solde/PEC/doc/osciloscopeLight.jpeg

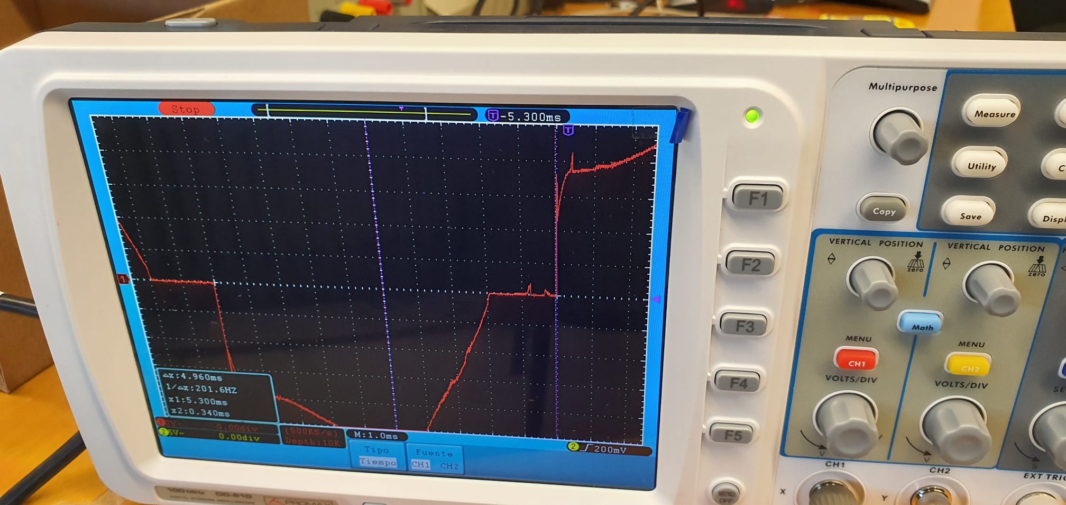
doc/osciloscopeLight.jpeg
