solde/PEC/doc/osciloscopeAc.jpeg

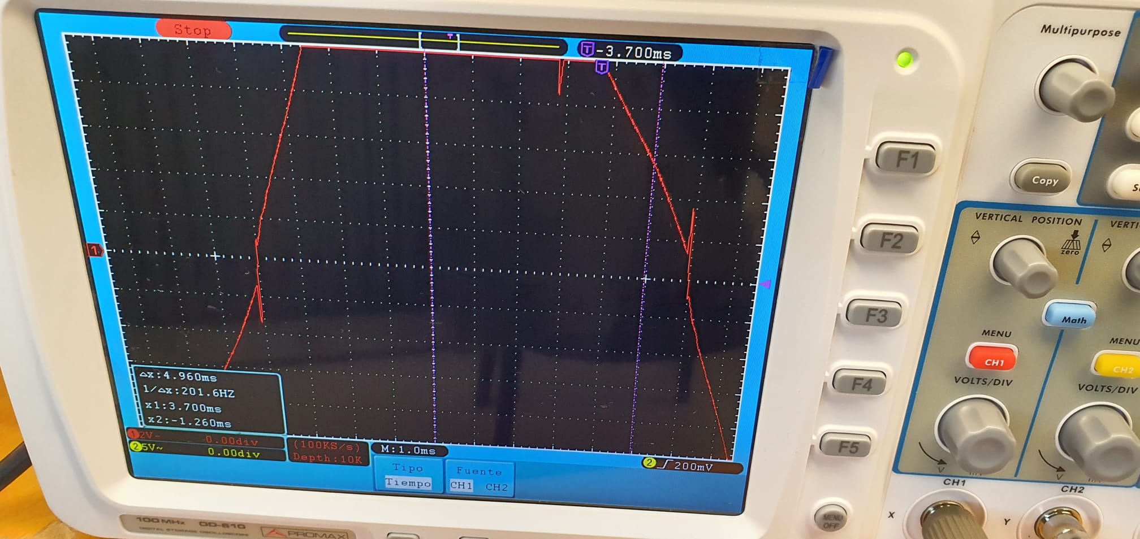
doc/osciloscopeAc.jpeg
