solde/PEC/doc/BOM.xlsx

Sheet: Comanda_Material
Provider | Description + Link | Code | Units | Prize | Total Prize
Leantec | MQ9 Gas sensor -> https://leantec.es/tienda/mq135-mq-135-sensor-air-quality-sensor-hazardous-gas-detection-module-arduino/ | 264389596457 | 1 | 2.90 € | 2.90 €
DigiKey | esp12 -> https://www.digikey.com/catalog/en/partgroup/esp8266-smt-module-esp-12e/59878 | 1528-1438-ND | 1 | 6.95 € | 6.95 €
DigiKey | optoisolator Triac -> https://www.digikey.es/product-detail/en/on-semiconductor/MOC3021M/MOC3021MFS-ND/284883 | MOC3021MFS-ND | 1 | 0.49 € | 0.49 €
Farnell | optoacoplator -> https://es.farnell.com/on-semiconductor/4n25m/optocoupler-transistor-o-p/dp/1021349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 | 1021349 | 1 | 0.45 € | 0.45 €
Farnell | Full Bridge Rectifier -> https://es.farnell.com/multicomp/w02g/diodo-puente-recific-1-fase-200v/dp/2675421?st=w02g | 2675421 | 1 | 0.45 € | 0.45 €
Farnell | Triac -> https://es.farnell.com/on-semiconductor/bd439g/transistor-npn-60v-4a-to-225/dp/2845299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 | 2845299 | 1 | 0.61 € | 0.61 €
Farnell | Led-Red 1206 -> https://es.farnell.com/kingbright/kpt-3216ec/led-1206-red-15mcd-625nm/dp/2099245?st=LED-1206 | 2099245 | 2 | 0.14 € | 0.29 €
Farnell | PIR -> https://es.farnell.com/mcm/287-18001/sensing-range-max-7m/dp/2830979 | 2830979 | 1 | 3.04 € | 3.04 €
DigiKey | Arduino Uno -> https://www.digikey.es/product-detail/en/arduino/A000073/1050-1041-ND/3476357 | A000073 | 1 | 18.59 € | 18.59 €
Farnell | LDR -> https://es.farnell.com/advanced-photonix/nsl-19m51/light-dependent-resistor-550nm/dp/3168335 | 3168335 | 1 | 1.11 € | 1.11 €
Farnell | Connector 2 pin -> https://es.farnell.com/phoenix-contact/1711725/bloque-terminal-pcb-5-08-mm-2/dp/3041165?st=conector%20tornillo | 3041165 | 3 | 1.16 € | 3.48 €
Farnell | Connector 3 pin ->https://es.farnell.com/phoenix-contact/1715734/bloque-terminal-pcb-3-v-as-26/dp/3041530?st=conector%20tornillo | 3041530 | 1 | 1.62 € | 1.62 €
Farnell | Temperature & Humidity DHT11 -> https://es.farnell.com/dfrobot/dfr0067/sensor-de-temperatura-humedad/dp/2946103 | 2946103 | 1 | 4.48 € | 4.48 €
Farnell | Connector 3 pin cable a placa -> https://es.farnell.com/harwin/m22-2010305/conector-macho-tht-2-mm-3-v-as/dp/671927 | 671927 | 3 | 0.13 € | 0.39 €
 |  |  |  | TOTAL = | 44.84 €

Sheet: Pivot_Table_1
(empty)
