solde/PEC/box/arduinoUnoSimplified.STEP

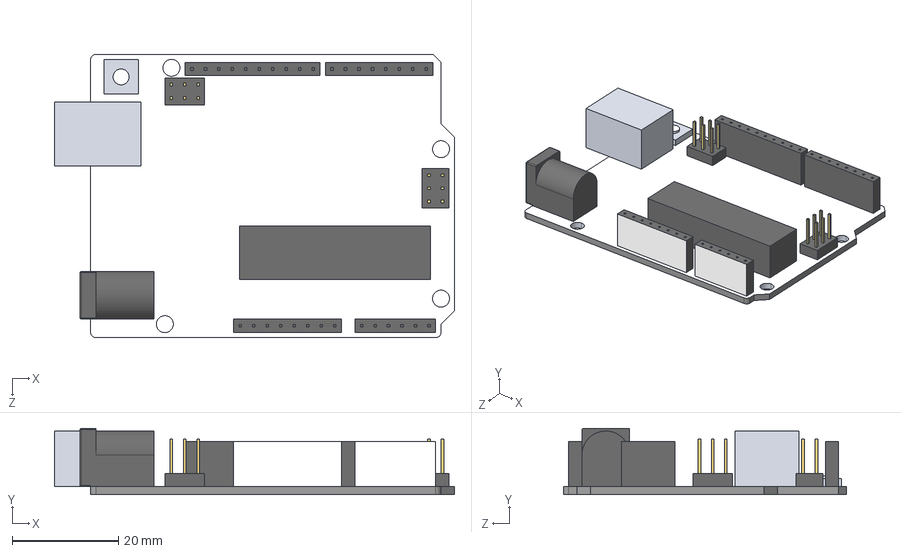
[picture p7: CAD file, 2019-12-27]
box/arduinoUnoSimplified.STEP
75.4 x 12.5 x 53.4 mm
