solde/PEC/box/case_base_arduino.STL

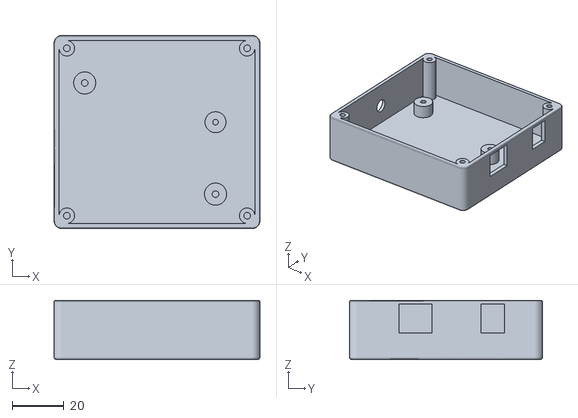
[picture p8: CAD file, 2019-12-27]
box/case_base_arduino.STL
80.0 x 75.0 x 23.0
