solde/PEC/(list of files, cad)

Other CAD files:
box/housing.skp
