solde/PEC/scm/GreenPCB/control AC.brd

## EAGLE design scm/GreenPCB/control AC.brd (2020-01-16)

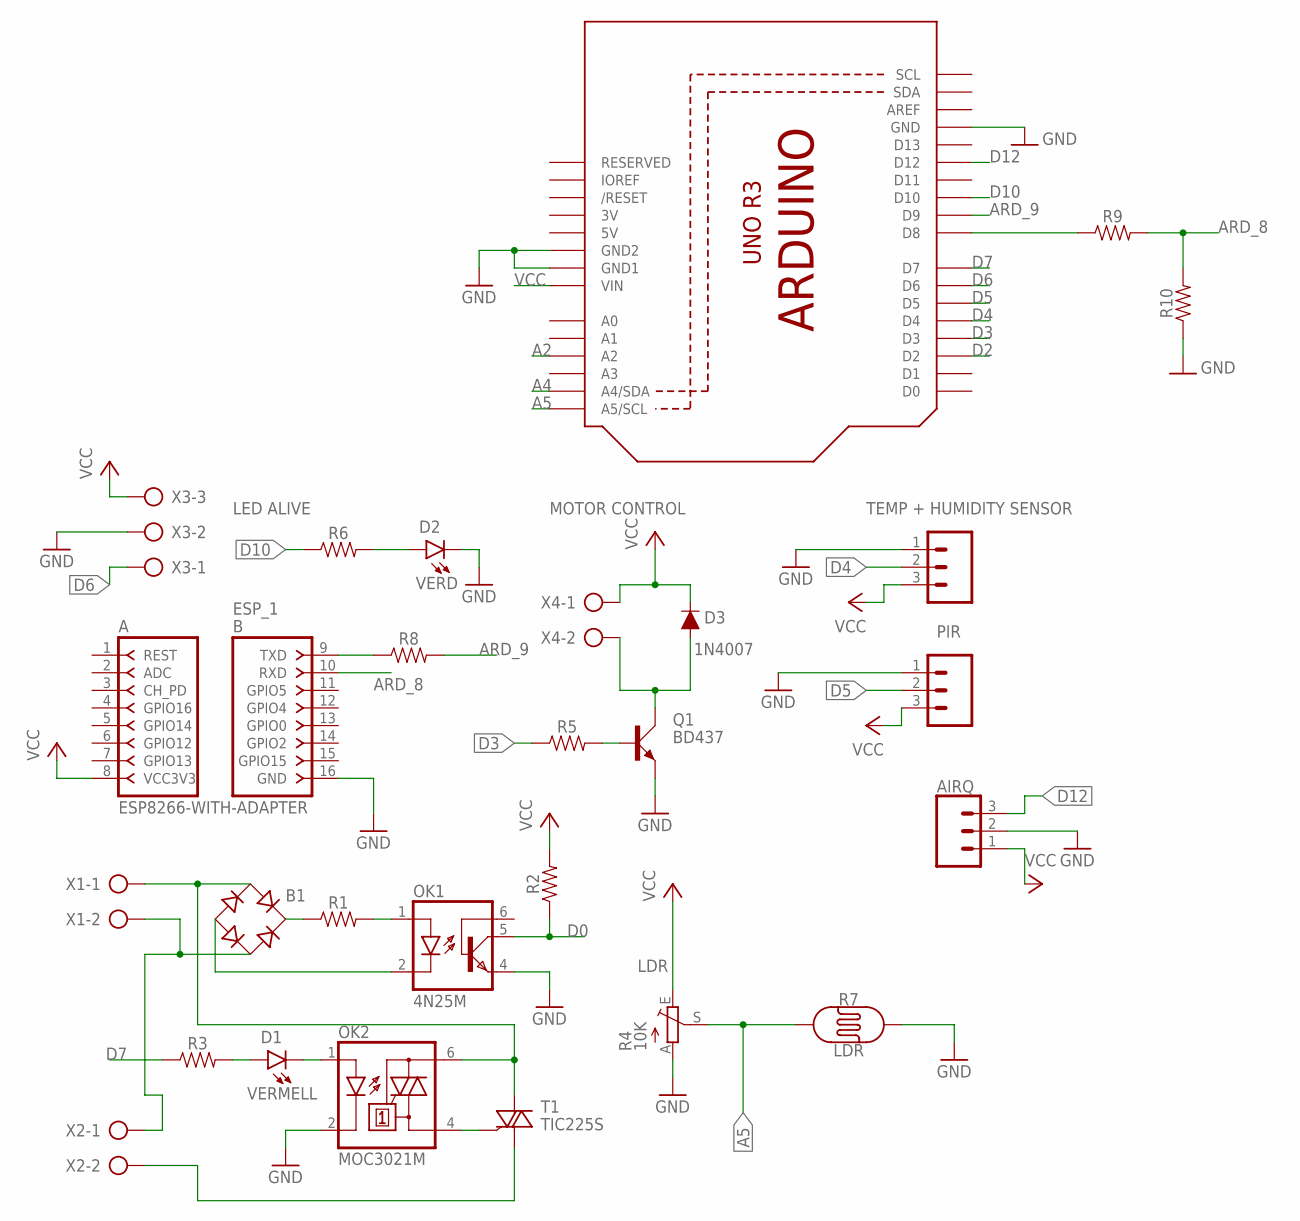
[picture p9: schematic control AC.sch]

Parts:
AIRQ: CONN_03; 1X03
B1: RB1A
D1: VERMELL; LED-1206
D2: VERD; FKIT-LED-1206
D3: 1N4007; DIODE-1N4001
ESP_1: ESP8266-WITH-ADAPTER; ESP8266-ADAPTER
OK1: 4N25M; DIL06
OK2: MOC3021M; DIL06
PIR: 455-1750-1-ND; 1X03
Q1: BD437; TO126AV
R1, R2, R3, R5, R6, R8, R9, R10: 0805
R4: 10K; LI10
R7: LDR; PHOTOCELL-KIT
T1: TIC225S; TO220DS
TEMP+HUM: 455-1750-1-ND; 1X03
U2: ARDUINOR3-DIMENSION; ARDUINOR3
X1, X2, X4: AK500/2
X3: AK500/3

Connections:
3V: U2.3V
5V: U2.5V
A2: U2.A2
A4: U2.A4 (A4/SDA)
A5: R4.S, R7.1, U2.A5 (A5/SCL)
ARD_8: ESP_1.10 (RXD), R9.2, R10.2
ARD_9: R8.2, U2.D9
D0: OK1.5 (COL), R2.1
D2: U2.D2
D3: R5.1, U2.D3
D4: TEMP+HUM.2, U2.D4
D5: PIR.2, U2.D5
D6: U2.D6, X3.1
D7: R3.1, U2.D7
D10: R6.1, U2.D10
D12: AIRQ.3, U2.D12
GND: AIRQ.2, D2.C, ESP_1.16 (GND), OK1.4 (EMI), OK2.2 (C), PIR.1, Q1.E, R4.A, R7.2, R10.1, TEMP+HUM.1, U2.GND, U2.GND1, U2.GND2, X3.2
unnamed: OK1.1 (A), R1.2
unnamed: B1.+, R1.1
unnamed: B1.-, OK1.2 (C)
unnamed: B1.AC1, OK2.6 (A2), T1.A2, X1.1
unnamed: B1.AC2, X1.2, X2.1
unnamed: Q1.B, R5.2
unnamed: D1.A, R3.2
unnamed: D1.C, OK2.1 (A)
unnamed: D2.A, R6.2
unnamed: OK2.4 (A1), T1.G
unnamed: T1.A1, X2.2
unnamed: D3.A, Q1.C, X4.2
unnamed: ESP_1.9 (TXD), R8.1
unnamed: R9.1, U2.D8
VCC: AIRQ.1, D3.C, ESP_1.8 (VCC3V3), PIR.3, R2.2, R4.E, TEMP+HUM.3, U2.VIN, X3.3, X4.1

Notes on the sheet:
LED ALIVE
MOTOR CONTROL
TEMP + HUMIDITY SENSOR
PIR
LDR

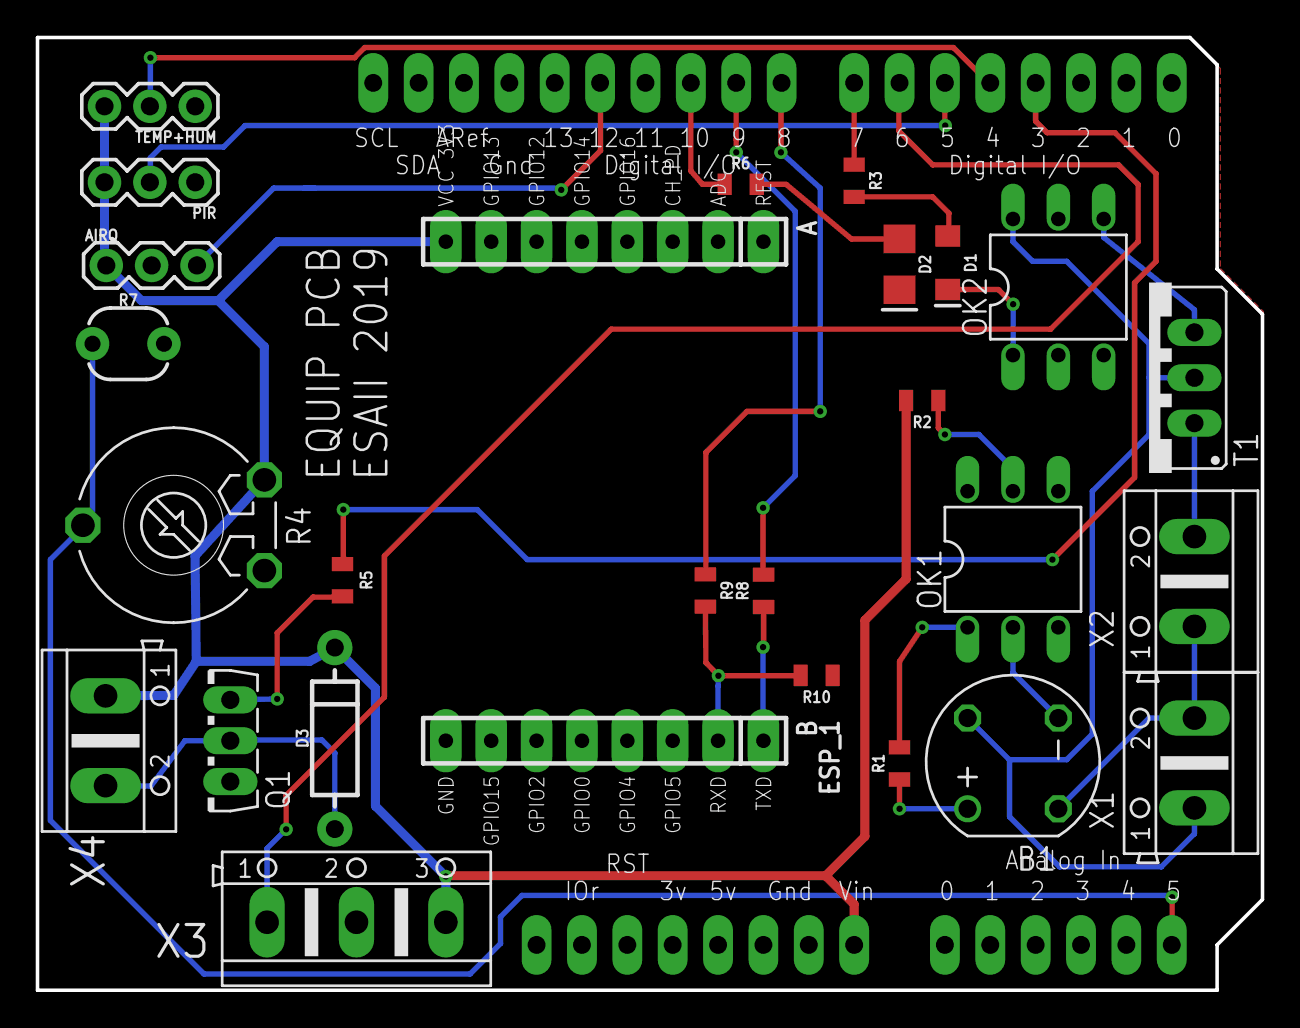
[picture p10: board control AC.brd from above]

Board: 2 copper layers, 68.6 x 53.3 mm, 27 parts (0 on the bottom side), 27 nets.
