solde/PEC/scm/dl3.brd

## EAGLE design scm/dl3.brd (2019-12-27)

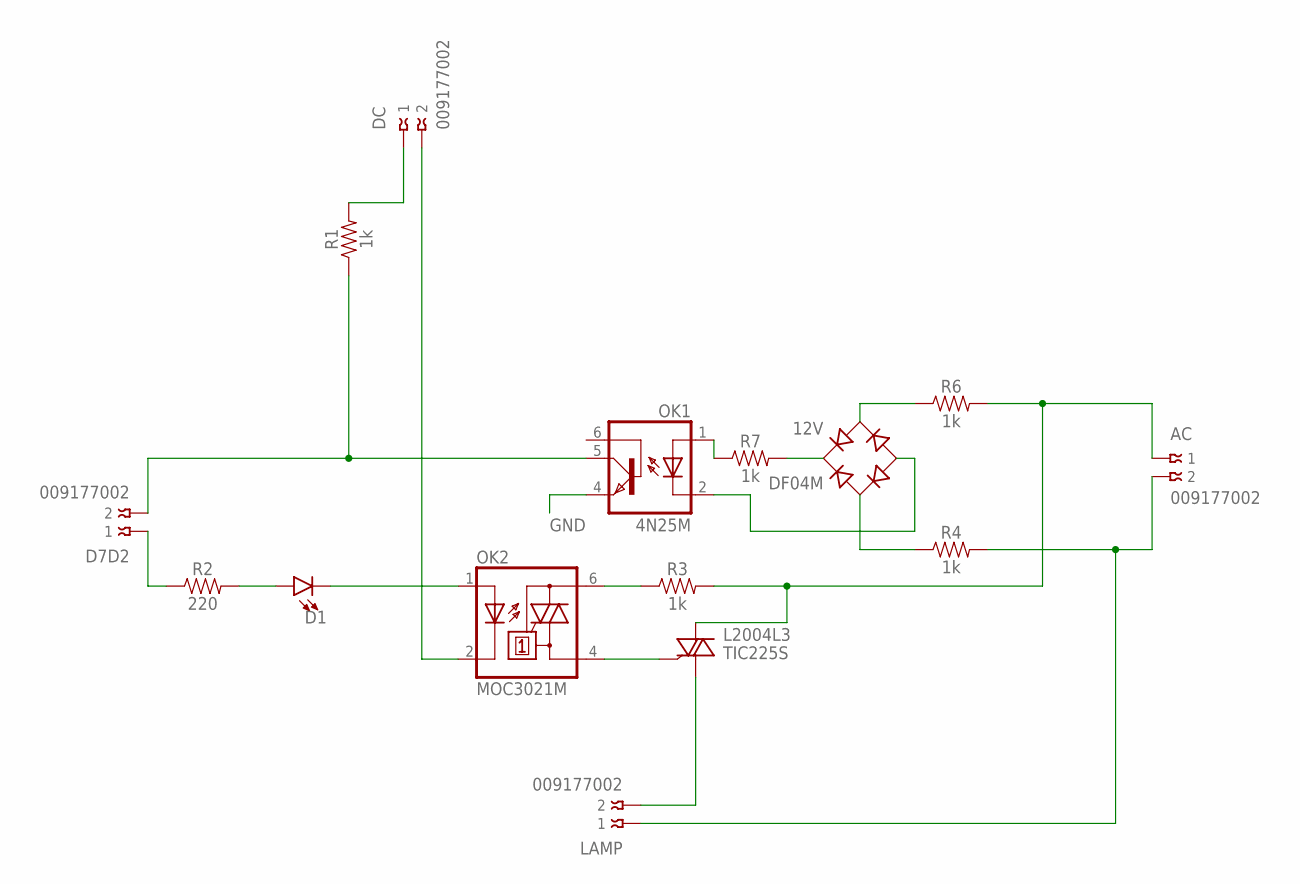
[picture p11: schematic dl3.sch]

Parts:
AC: 009177002
D1: LED1206; LED-1206
D7D2: 009177002
DC: 009177002
DF04M: 12V; B-DIL
L2004L3: TIC225S; TO220DS
LAMP: 009177002
OK1: 4N25M; DIL06
OK2: MOC3021M; DIL06
R1, R3, R4, R6: 1k; AXIAL-0.3
R2: 220; 0805
R7: 1k; 0805

Connections:
GND: AC.2, LAMP.1, OK1.4 (EMI), R4.P$2 (2)
IO2: D7D2.2, OK1.5 (COL), R1.P$1 (1)
unnamed: DF04M.+, R7.2
unnamed: D1.A, R2.2
unnamed: D1.C, OK2.1 (A)
unnamed: D7D2.1, R2.1
unnamed: DC.1, R1.P$2 (2)
unnamed: OK2.6 (A2), R3.P$1 (1)
unnamed: L2004L3.G, OK2.4 (A1)
unnamed: OK1.1 (A), R7.1
unnamed: DF04M.-, OK1.2 (C)
unnamed: DF04M.AC1, R4.P$1 (1)
unnamed: DC.2, OK2.2 (C)
unnamed: AC.1, L2004L3.A2, R3.P$2 (2), R6.P$2 (2)
unnamed: DF04M.AC2, R6.P$1 (1)
unnamed: L2004L3.A1, LAMP.2

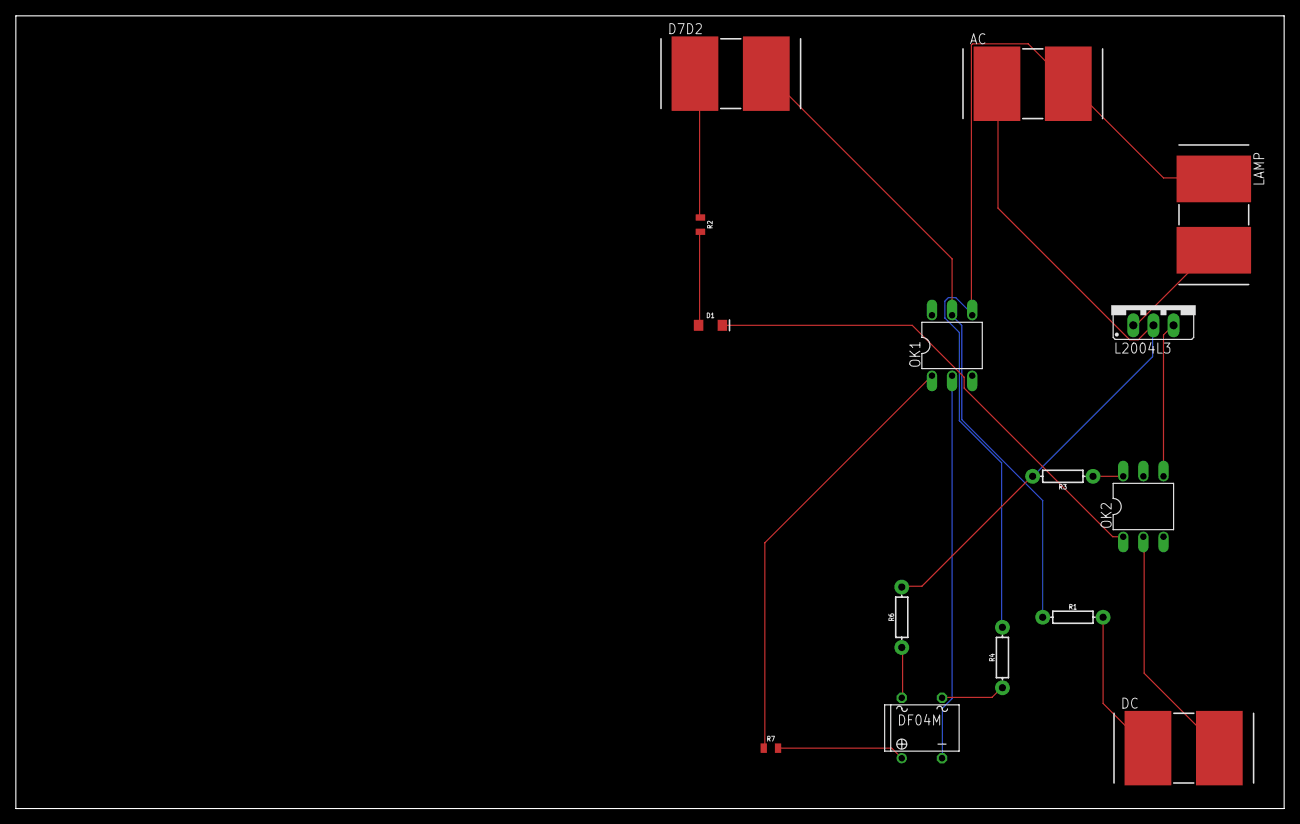
[picture p12: board dl3.brd from above]

Board: 2 copper layers, 160.0 x 100.0 mm, 15 parts (0 on the bottom side), 16 nets.
