solde/PEC/scm/LightDiming.brd

## EAGLE design scm/LightDiming.brd (2019-12-27)

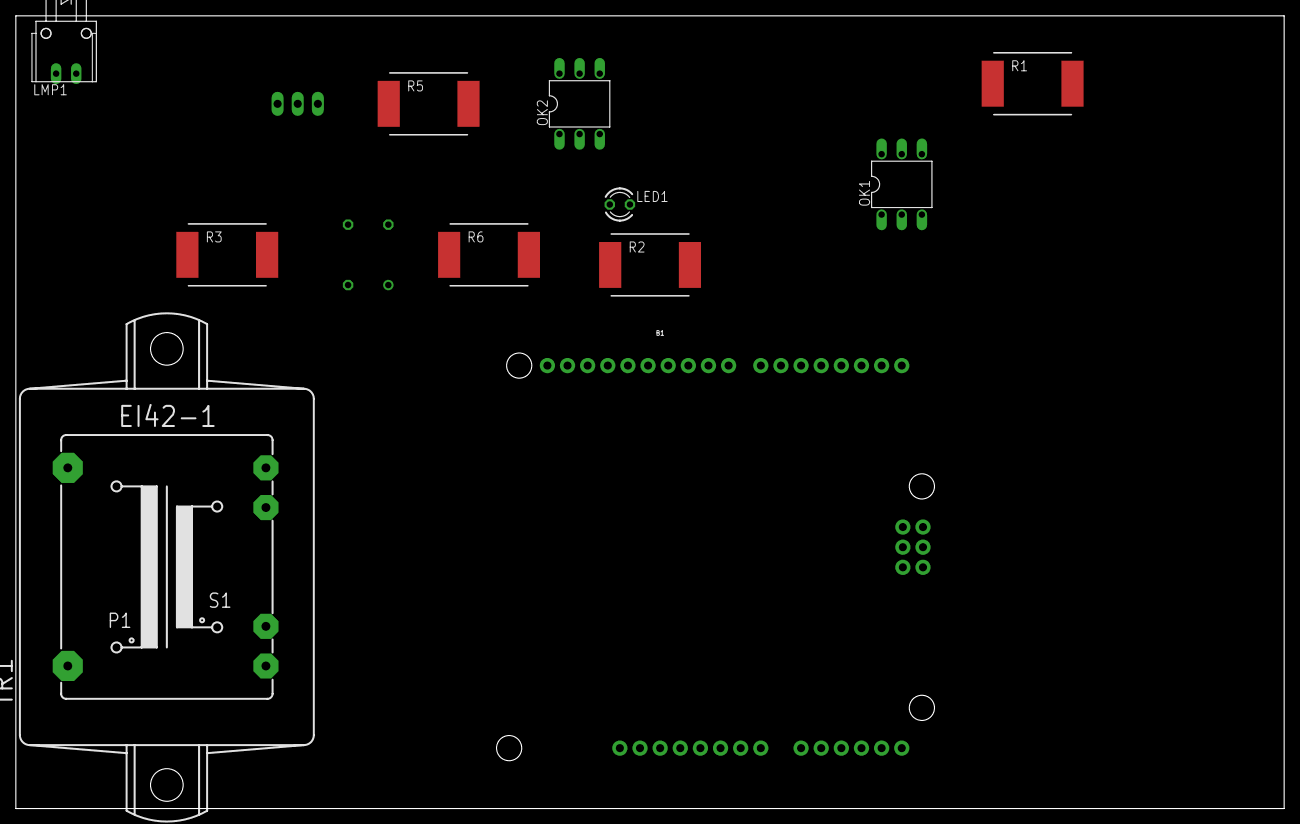
[picture p13: board LightDiming.brd from above]

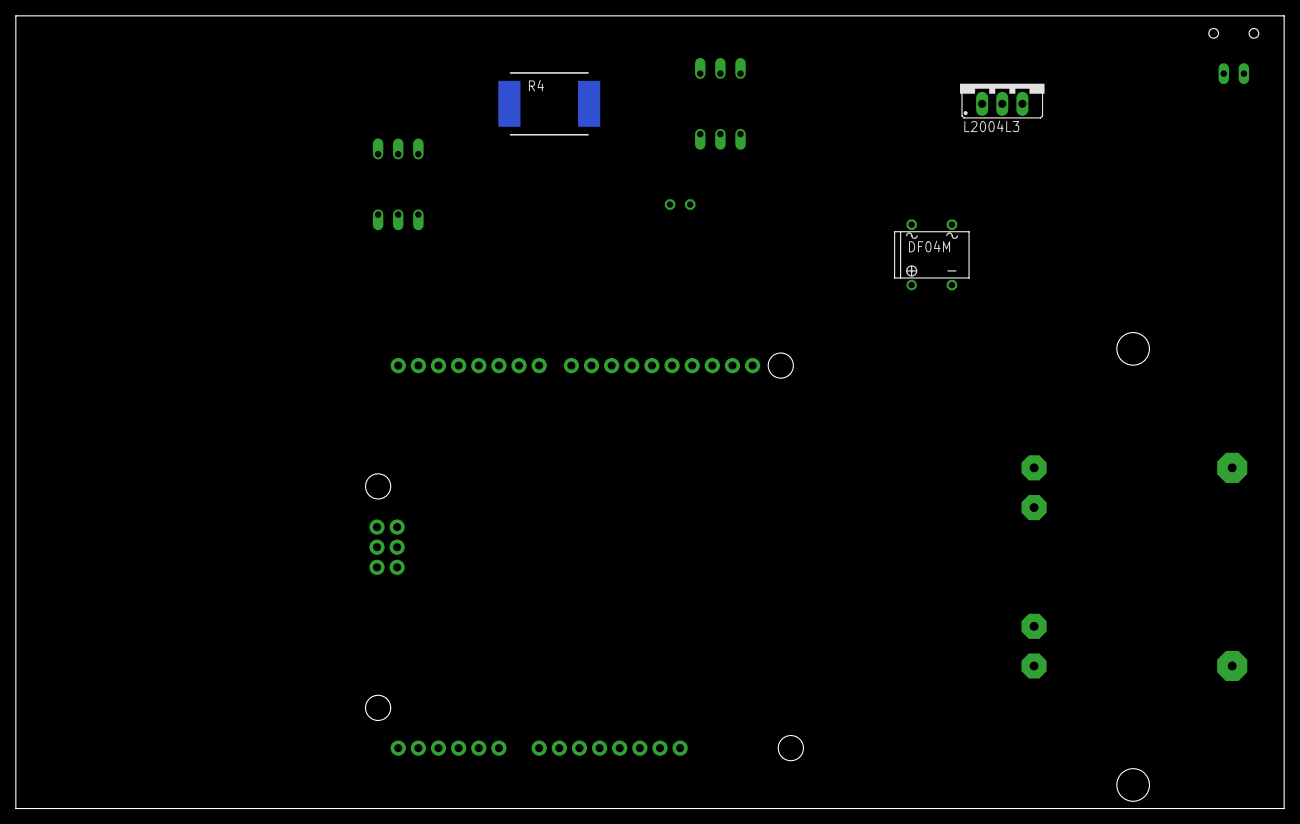
[picture p14: board LightDiming.brd from below]

Board: 2 copper layers, 160.0 x 100.0 mm, 14 parts (3 on the bottom side), 14 nets, no tracks yet.

Parts:
B1: ARDUINO_UNO_R3; ARDUINO_R3
DF04M: B-DIL
L2004L3: TIC225S; TO220DS
LED1: TLLR4400; LED3MM
LMP1: LDH-5R
OK1: 4N25M; DIL06
OK2: MOC3021M; DIL06
R1, R2, R3, R4, R5, R6: SMR-0
TR1: EI42-1B

Connections:
GND: LMP1.1, OK1.4, OK2.2, R4.2, TR1.7
IO0: B1.D7, R2.1
IO2: B1.D0, OK1.5, R1.2
unnamed: DF04M.+, R6.2
unnamed: LED1.A, R2.2
unnamed: LED1.K, OK2.1
unnamed: OK2.6, R5.1
unnamed: L2004L3.G, OK2.4
unnamed: OK1.1, R6.1
unnamed: DF04M.-, OK1.2
unnamed: DF04M.AC1, R4.1
unnamed: L2004L3.A2, R3.2, R5.2, TR1.9
unnamed: DF04M.AC2, R3.1
unnamed: L2004L3.A1, LMP1.2
