solde/PEC/(commit log)

2019-12-30 una mala soldadura es como un if mal instanciado
    [housing.skp]
2019-12-30 LO IMPORTANTE ES HACER LA PCB
2020-01-02 El pico de un pato es como la cabeza de un perro
2020-01-16 El bec del anec es un gos
    [control AC.brd, control AC.sch]
